HonagF/HCMUS_ADC_Oscilloscope/Photos/First_testing.jpg

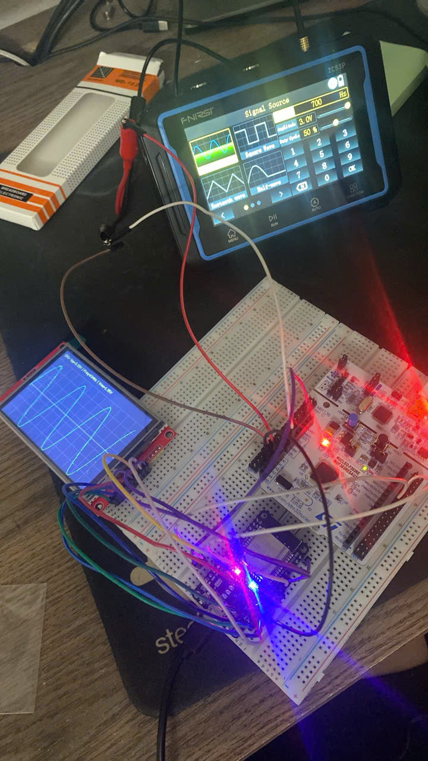
Photos/First_testing.jpg
