HonagF/HCMUS_ADC_Oscilloscope/Photos/Inside.jpg

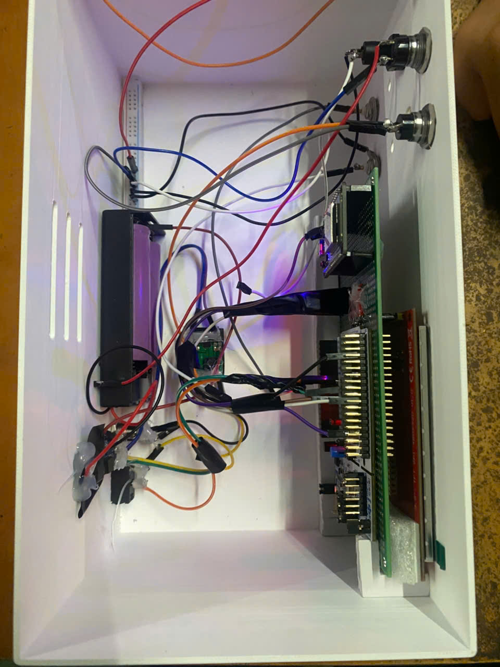
Photos/Inside.jpg
