HonagF/HCMUS_ADC_Oscilloscope/README.md

[Project Information](https://docs.google.com/document/d/1wfRh9YXK25s_UUH2y_-TGw_fSxXpMR-pIrb6TqXOmT0/edit?tab=t.250vvrg7rc1h)

https://github.com/user-attachments/assets/9503c086-c768-495d-8c4e-90152d3b3db1

 ## I. Introduction
### Project Overview
This repository hosts a self-developed **Digital Storage Oscilloscope (DSO)** project. It was built as a core team assignment for the Microcontrollers course within the Faculty of Electronics and Telecommunications at the VNU-HCM University of Science (Academic Year 2025-2026).

The architecture utilizes a distributed processing layout across a hybrid multi-microcontroller setup to ensure smooth, high-speed performance:
* **Data Acquisition Block (STM32F303RE):** Handles high-speed analog signal sampling through its internal 12-bit ADC, utilizing DMA to offload data storage from the CPU pipeline.
* **Processing & Display Block (ESP32):** Manages incoming data packets over SPI, executes processing tasks, hosts the web interface, and handles graphical UI rendering.
* **Human-Machine Interface (HMI):** Displays waveforms smoothly on a 3.5-inch TFT touch screen powered by the ILI9488 controller (320x480 pixel resolution).

The system combines concepts from Basic Electronics, Digital Electronics, Analog Electronics, and Microcontrollers to deliver a functional measurement tool tailored for educational settings and fundamental laboratory testing.

---

Our **DualCore Scope** team:

| Name | Roles & Responsibilities |
| :--- | :--- |
| [**Vũ Quốc Hùng**](https://github.com/HungVulkan) | <ul><li>Team Leader</li><li>Hardware Development</li><li>GitHub Management</li></ul> |
| [**Nguyễn Minh Hoàng**](https://github.com/HonagF) | <ul><li>Firmware (STM32, ESP32)</li><li>System Functions & UI Display</li><li>GitHub Management</li></ul> |
| **Đặng Hữu Trung Kiên** | <ul><li>3D design</li><li>Slide Preparation</li></ul> |
| **Đỗ Hoàng Đạt** | <ul><li>Firmware (ESP32), web interface</li><li>Hardware Assistance</li></ul> |

 ## II. Hardware

| Component | Model | Quantity |
|---|---|---|
| Microcontroller | STM32F303RE (Nucleo-64) | 1 |
| WiFi MCU | ESP32 DevKit V1 | 1 |
| Display | ILI9488 3.5" TFT SPI | 1 |
| Signal input | BNC Female Header | 2 |
| User input | Momentary pushbutton | 3 |
| User input | Latching pushbutton | 2 |
| User input | Rotary encoder | 1 |
| Signal conditioning | Custom signal adjustment circuit | 2 |
| Power | 7.4V power supply → 8.4V boosted | 1 |

<p align="center">
  NUCLEO-F303RE Board
</p>
<p align="center">
  ESP32_DevKit_V1
</p>
<p align="center">

</p>

Although we designed this circuit, when we built it on a perfboard, it worked initially but broke down a few days later. Due to time constraints, we had to abandon it. We hope you will carry on this work in our place.
<p align="center">

</p>

---
 ## III. Software
For the software, besides the signal processing algorithm on the STM32F303RE, we designed an interface on a 3.5-inch TFT SPI display using the ILI9488. Due to local stock limitations, a touchscreen version was provisionally used instead of the standard non-touch model. (Users could also opt for more common alternatives like the 2.8-inch ILI9341 to fit their needs)
<p align="center">

</p>

Additionally, we have developed an interface on the ESP32, along with other features, making it open-source for further development.
<p align="center">

</p>
