HonagF/HCMUS_ADC_Oscilloscope/Photos/Back_MCU.jpg

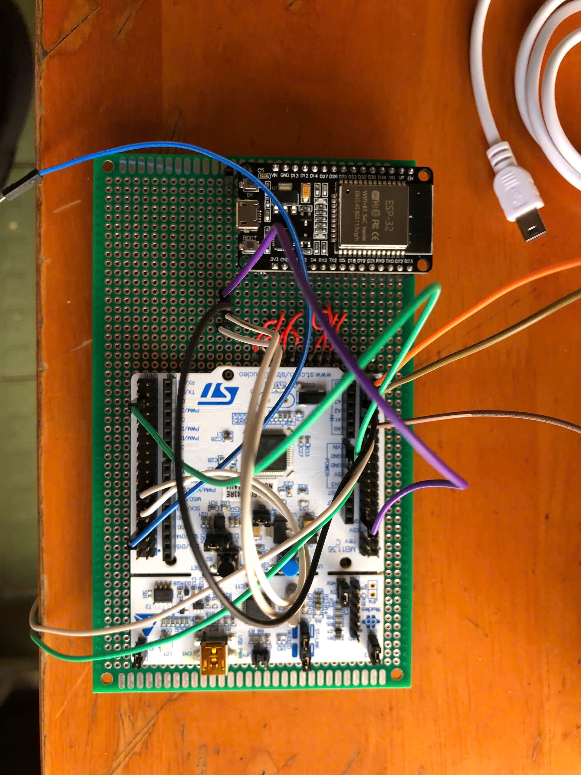
Photos/Back_MCU.jpg
