HonagF/HCMUS_ADC_Oscilloscope/Photos/Front_MCU.jpg

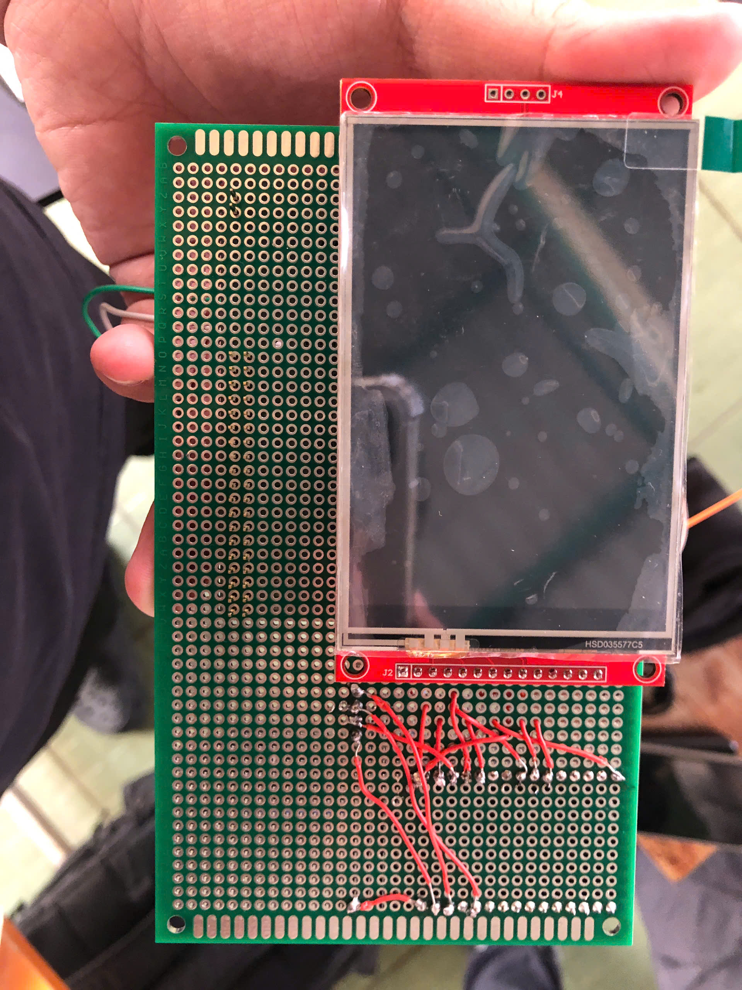
Photos/Front_MCU.jpg
