HonagF/HCMUS_ADC_Oscilloscope/Photos/Signal_adjustment_circuit.jpg

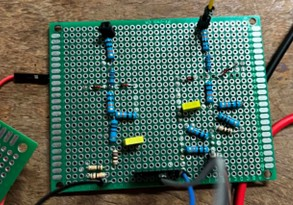
Photos/Signal_adjustment_circuit.jpg
