HonagF/HCMUS_ADC_Oscilloscope/Photos/Tesing_SAC.png

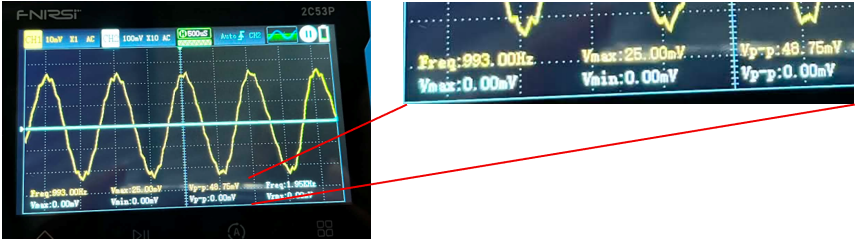
Photos/Tesing_SAC.png
