HonagF/HCMUS_ADC_Oscilloscope/Photos/UIUX_LCD.jpg

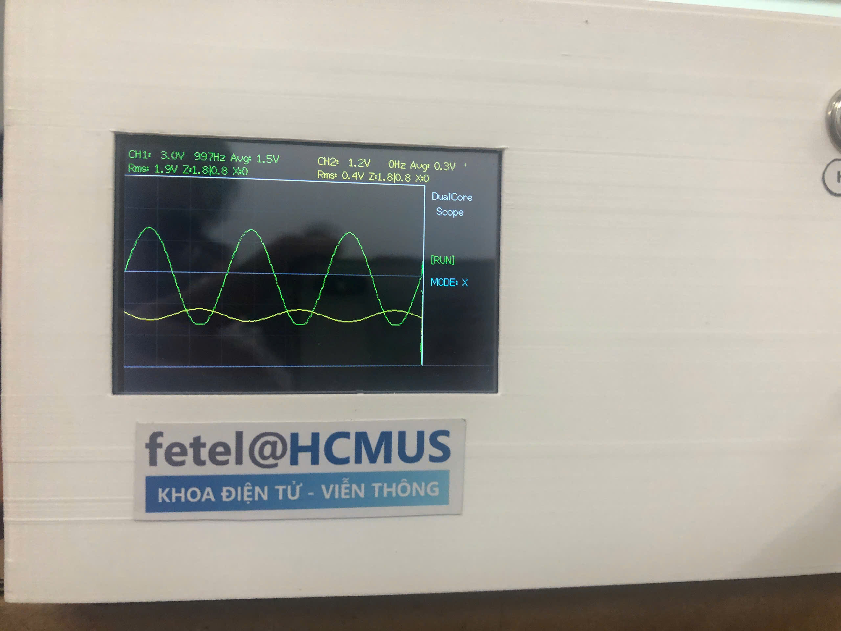
Photos/UIUX_LCD.jpg
