HonagF/HCMUS_ADC_Oscilloscope/Photos/UIUX_LCD_2.jpg

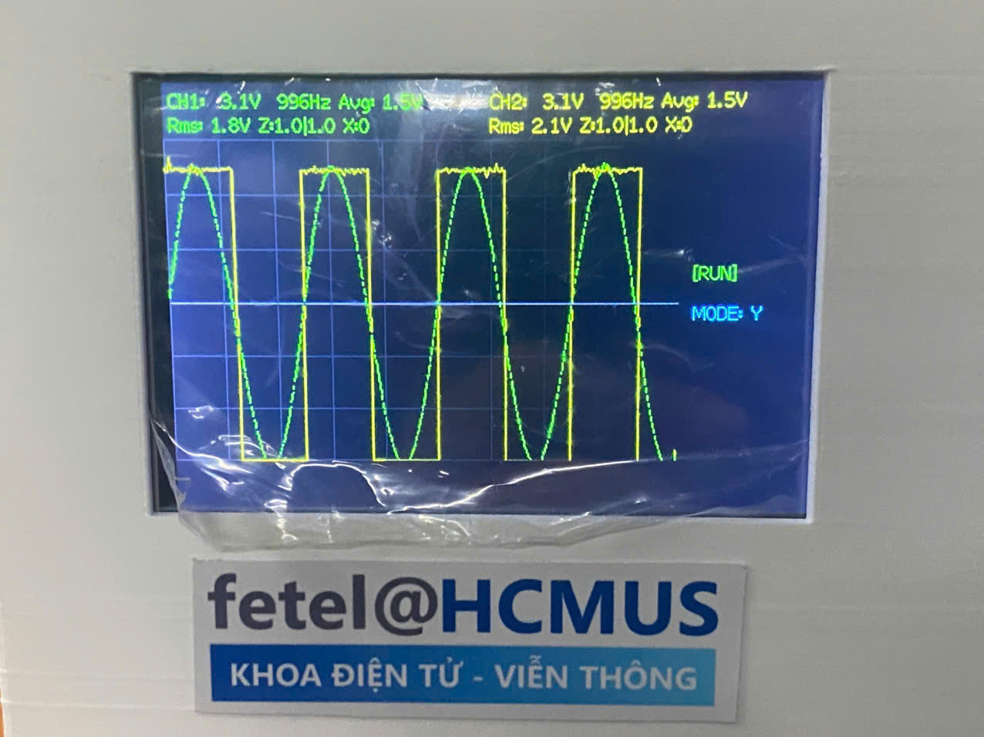
Photos/UIUX_LCD_2.jpg
