HonagF/HCMUS_ADC_Oscilloscope/Photos/We_did_it.jpg

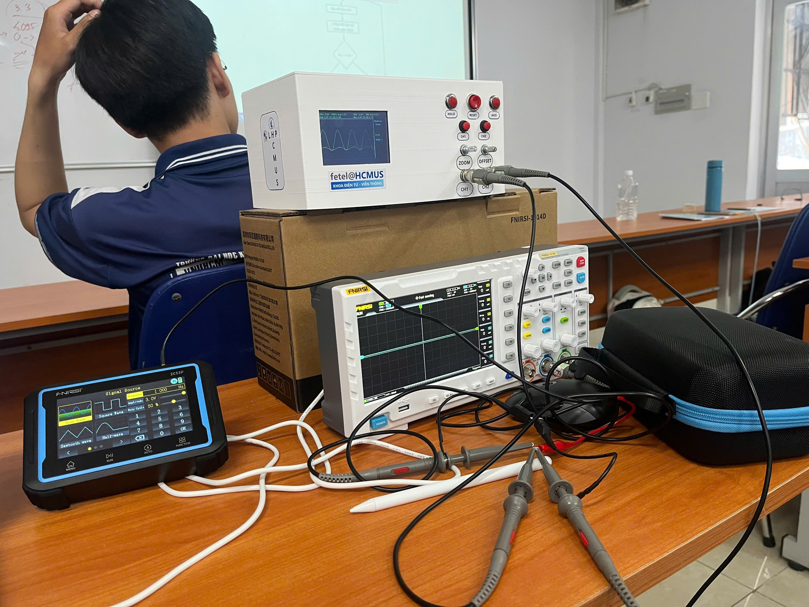
Photos/We_did_it.jpg
