HonagF/HCMUS_ADC_Oscilloscope/Photos/Web_interface.png

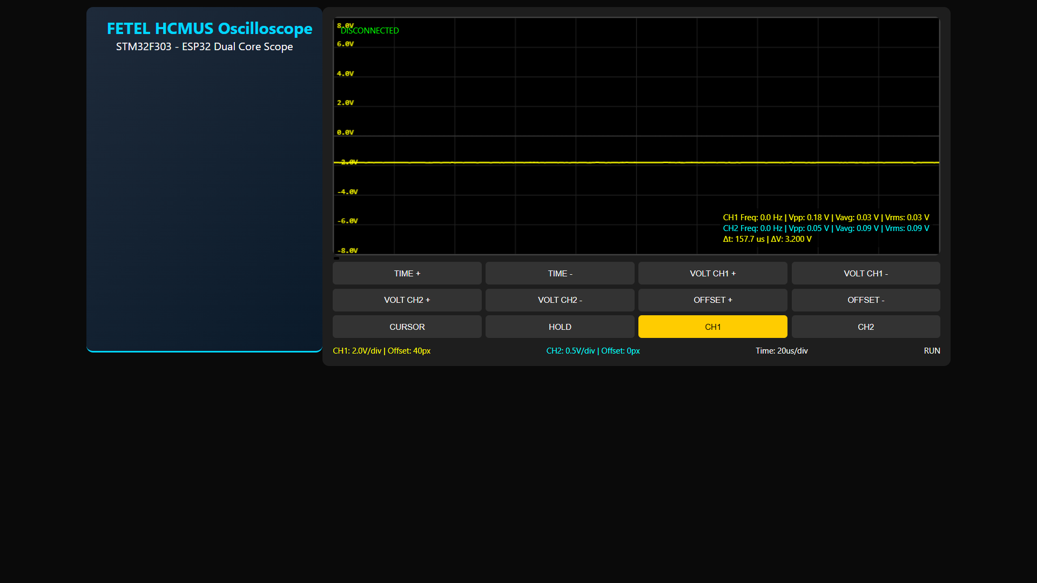
Photos/Web_interface.png
