HonagF/HCMUS_ADC_Oscilloscope/schematic/ESP32.png

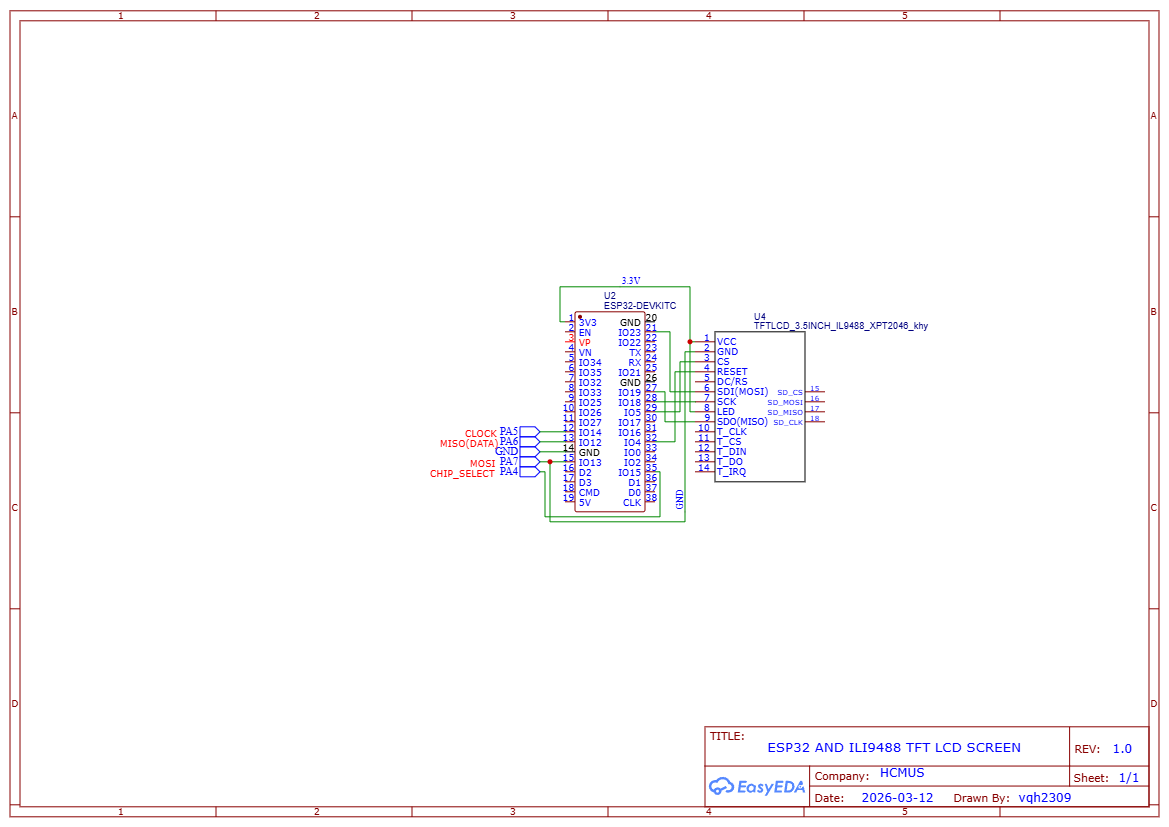
schematic/ESP32.png
