HonagF/HCMUS_ADC_Oscilloscope/schematic/FUNCTION.png

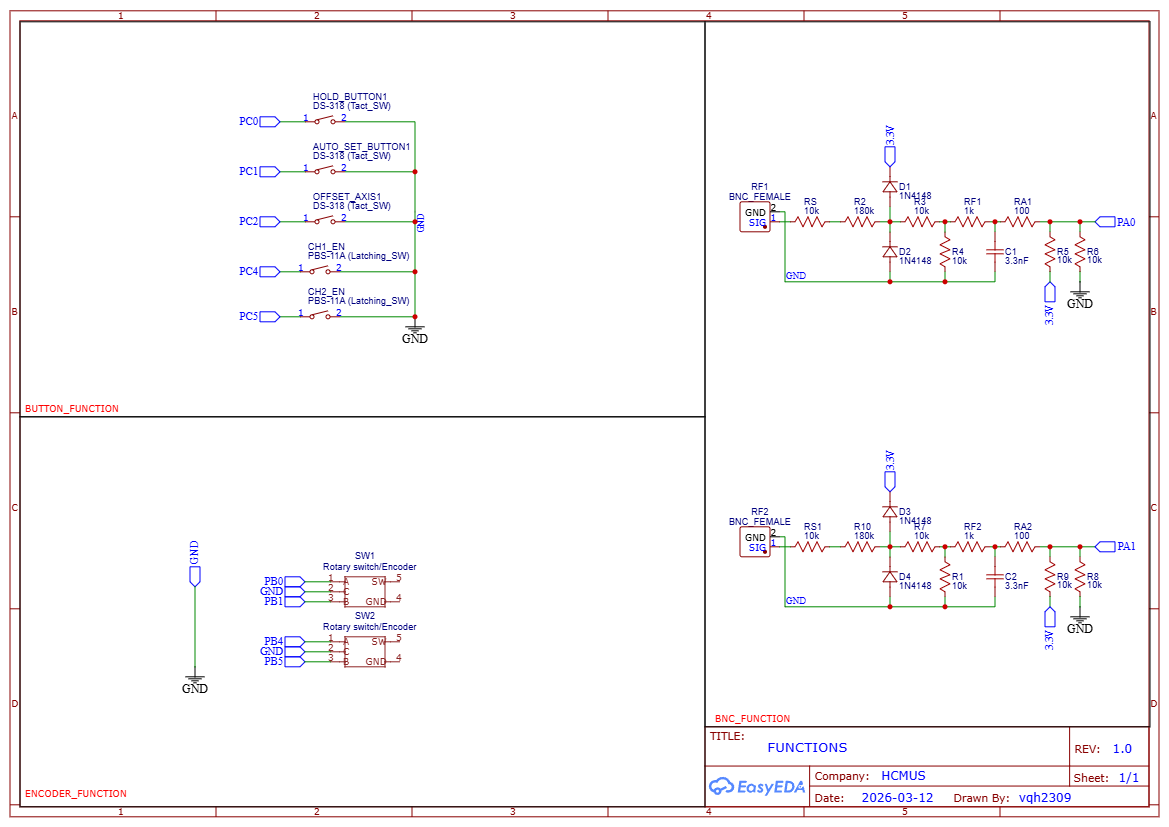
schematic/FUNCTION.png
