HonagF/HCMUS_ADC_Oscilloscope/schematic/STM32.png

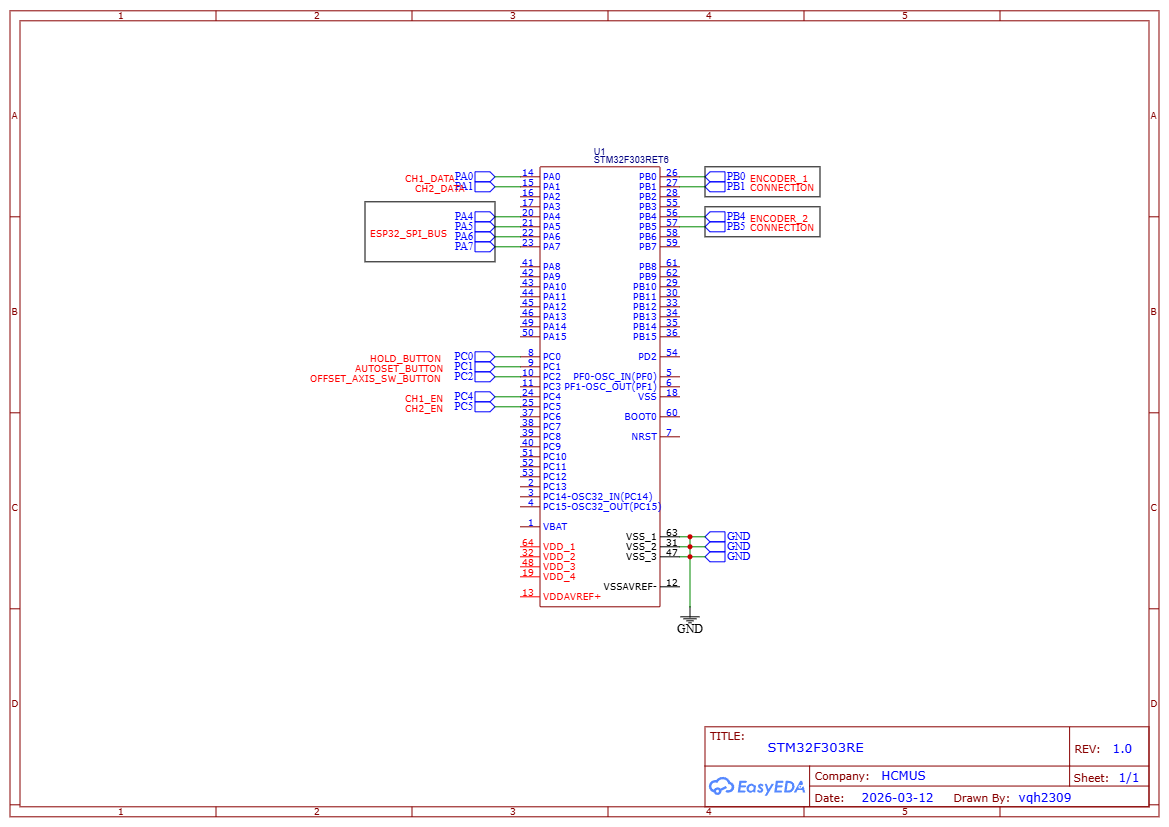
schematic/STM32.png
