HonagF/HCMUS_ADC_Oscilloscope/STM32Firmware/STM32Firmware.ioc

Mcu.UserName=STM32F303RETx
PA0.Signal=ADC1_IN1
PA13.GPIO_Label=TMS
PA13.Signal=SYS_JTMS-SWDIO
PA14.GPIO_Label=TCK
PA14.Signal=SYS_JTCK-SWCLK
PA2.GPIO_Label=USART_TX
PA2.Signal=USART2_TX
PA3.GPIO_Label=USART_RX
PA3.Signal=USART2_RX
PA4.GPIO_Label=SPI_CS
PA4.Signal=GPIO_Output
PA5.Signal=SPI1_SCK
PA6.Signal=GPIO_Output
PA7.Signal=SPI1_MOSI
PB0.Signal=GPIO_Input
PB1.Signal=GPIO_Input
PB3.GPIO_Label=SWO
PB3.Signal=SYS_JTDO-TRACESWO
PB4.Signal=GPIO_Input
PB5.Signal=GPIO_Input
PC0.Signal=GPIO_Input
PC1.Signal=GPIO_Input
PC13.GPIO_Label=B1 [Blue PushButton]
PC13.Signal=GPXTI13
PC14-OSC32_IN.Signal=RCC_OSC32_IN
PC15-OSC32_OUT.Signal=RCC_OSC32_OUT
PC2.Signal=GPIO_Input
PC3.Signal=ADCx_IN9
PC4.Signal=GPIO_Input
PC5.Signal=GPIO_Input
PF0-OSC_IN.Signal=RCC_OSC_IN
PF1-OSC_OUT.Signal=RCC_OSC_OUT
