HonagF/HCMUS_ADC_Oscilloscope/STM32Firmware/Core/Src/main.c

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
/* Includes ------------------------------------------------------------------*/
#include "main.h"

/* USER CODE BEGIN Includes */
#include <string.h>
#include <math.h>
/* USER CODE END Includes */

ADC_HandleTypeDef hadc1;
ADC_HandleTypeDef hadc2;
DMA_HandleTypeDef hdma_adc1;
DMA_HandleTypeDef hdma_adc2;

SPI_HandleTypeDef hspi1;
DMA_HandleTypeDef hdma_spi1_tx;

TIM_HandleTypeDef htim3;

UART_HandleTypeDef huart2;

/* USER CODE BEGIN PV */
// Set số lượng mẫu thu thập cho mỗi khung hình là 1024 mẫu/kênh
#define SAMPLES_PER_CH    1024
// Tổng số mẫu DMA cần lấy = Kênh 1 + Kênh 2
#define TOTAL_SAMPLES	(SAMPLES_PER_CH * 2)

// Khai báo struct đóng gói dữ liệu truyền qua SPI.
// dùng __attribute__((packed)) để vô hiệu hóa tính năng tự động đệm (padding) của GCC.
typedef struct __attribute__((packed)){
	uint8_t header[2]; // Byte header: 0xAA, 0xBB để ESP32 nhận diện điểm bắt đầu gói tin
	uint16_t ch1[SAMPLES_PER_CH]; // Dữ liệu thô ADC Kênh 1 (1024 mẫu * 2 byte = 2048 bytes)
	uint16_t ch2[SAMPLES_PER_CH]; // Dữ liệu thô ADC Kênh 2 (1024 mẫu * 2 byte = 2048 bytes)
	uint8_t padding[2]; // 2 byte padding thủ công để chống lỗi Hardfault do Misaligned memory access trên vi điều khiển ARM

	// Các thông số điện áp & thời gian đo được
	float vpp1, vpp2; // Điện áp đỉnh-đỉnh (Peak-to-Peak)
	float freq1, freq2; // Tần số (Frequency)
	float vavg1, vavg2; // Điện áp trung bình (Average/DC Offset)
	float vrms1, vrms2; // Điện áp hiệu dụng thực (True RMS)
	float vamp1, vamp2; // Biên độ sóng (Amplitude)
	uint16_t trigger_idx1; // Vị trí điểm kích hoạt (Trigger Point) trong mảng để ESP32 làm mốc vẽ sóng
	uint16_t trigger_idx2;

	// --- KHỐI ĐIỀU KHIỂN (Giao tiếp với giao diện LCD) ---
	uint8_t hold_flag; // Cờ dừng màn hình (0: Đang chạy, 1: Giữ nguyên khung hình)
	uint8_t ch_mode;   // Cờ bitmask chọn kênh hiển thị (1: CH1, 2: CH2, 3: Bật cả 2 kênh)
	float y_scale1;    // Hệ số phóng to/thu nhỏ trục Y của CH1 (điều khiển bởi Encoder 1)
	float y_scale2;    // Hệ số phóng to/thu nhỏ trục Y của CH2 (điều khiển bởi Encoder 1)
	float x_scale1;	   // Hệ số thu phóng trục X của CH1
	float x_scale2;    // Hệ số thu phóng trục Y của CH2
	int16_t y_offset1; // Số pixel dịch chuyển sóng lên/xuống của CH1
	int16_t y_offset2; // Số pixel dịch chuyển sóng lên/xuống của CH2

	// --- KHỐI OFFSET X/Y ---
	uint8_t offset_axis; // Trạng thái của nút nhấn: 0 đang chọn chỉnh Y, 1 đang chọn chỉnh X
	int16_t x_offset1; // Số pixel dịch chuyển trục thời gian (X) cho CH1
	int16_t x_offset2; // Số pixel dịch chuyển trục thời gian (X) cho CH2
	uint8_t reset_flag; // Cờ reset

	uint8_t footer[2]; // Byte footer: 0xCC, 0xDD
} Packet_t;

Packet_t tx_packet; // Khởi tạo biến toàn cục chứa gói tin
#define PACKET_SIZE sizeof(Packet_t)
uint8_t adc_running = 1;
volatile uint8_t adc1_ready = 0;
volatile uint8_t adc2_ready = 0;
volatile uint8_t is_holding = 0;
/* USER CODE END PV */

void SystemClock_Config(void);
static void MX_GPIO_Init(void);
static void MX_DMA_Init(void);
static void MX_TIM3_Init(void);
static void MX_USART2_UART_Init(void);
static void MX_SPI1_Init(void);
static void MX_ADC1_Init(void);
static void MX_ADC2_Init(void);
/* USER CODE BEGIN PFP */
// Hàm xử lý tín hiệu: Tìm Trigger, tính Vrms, Vpp, Freq
uint16_t Process_Signal(uint16_t* raw_data, float* vpp, float* freq, float* vavg, float* vrms, float* vamp);
/* USER CODE END PFP */

/**
  * @brief  The application entry point.
  * @retval int
  */
int main(void)
{

  /* MCU Configuration--------------------------------------------------------*/

  /* Reset of all peripherals, Initializes the Flash interface and the Systick. */
  HAL_Init();

  /* Configure the system clock */
  SystemClock_Config();

  /* Initialize all configured peripherals */
  MX_GPIO_Init();
  MX_DMA_Init();
  MX_TIM3_Init();
  MX_USART2_UART_Init();
  MX_SPI1_Init();
  MX_ADC1_Init();
  MX_ADC2_Init();
  /* USER CODE BEGIN 2 */
  // Khởi tạo ban đầu: Chốt chân Chip Select (CS) của SPI ở mức CAO (Không truyền)
  HAL_GPIO_WritePin(GPIOA, GPIO_PIN_4, GPIO_PIN_SET);

  // Set cứng các byte Header và Footer để định dạng gói tin giao thức
  tx_packet.header[0] = 0xAA;
  tx_packet.header[1] = 0xBB;
  tx_packet.footer[0] = 0xCC;
  tx_packet.footer[1] = 0xDD;



  // Calib ADC để loại bỏ sai số nội vi trước khi chạy thực tế
//  HAL_ADCEx_Calibration_Start(&hadc1, ADC_SINGLE_ENDED);
//  HAL_ADCEx_Calibration_Start(&hadc2, ADC_SINGLE_ENDED);
  // Kích hoạt bộ chuyển đổi ADC chạy ở chế độ DMA Circular
  HAL_ADC_Start_DMA(&hadc1, (uint32_t*)tx_packet.ch1, SAMPLES_PER_CH);
  HAL_ADC_Start_DMA(&hadc2, (uint32_t*)tx_packet.ch2, SAMPLES_PER_CH);

  // Khởi động Timer 3. Timer 3 được cấu hình làm TRGO (Trigger Output) tạo xung đập nhịp 100kHz để kích ADC lấy mẫu.
  HAL_TIM_Base_Start(&htim3);

  // Khởi tạo các biến quản lý trạng thái
  uint32_t last_btn_tick = 0;
  tx_packet.y_scale1 = 1.0f;
  tx_packet.y_scale2 = 1.0f;
  tx_packet.x_scale1 = 1.0f;
  tx_packet.x_scale2 = 1.0f;
  tx_packet.y_offset1 = 0;
  tx_packet.y_offset2 = 0;
  tx_packet.offset_axis = 0;
  tx_packet.x_offset1 = 0;
  tx_packet.x_offset2 = 0;

  // Biến lưu trạng thái của 2 chân CLK Encoder để so sánh cạnh xuống
  uint8_t last_clk1 = 1;
  uint8_t last_clk2 = 1;
  // Khởi tạo 2 biến dùng để chống dội phím (Debounce) cho Encoder
  uint32_t last_enc1_tick = 0;
  uint32_t last_enc2_tick = 0;
  /* USER CODE END 2 */

  /* Infinite loop */
  /* USER CODE BEGIN WHILE */


  while (1)
  {
    /* USER CODE END WHILE */

    /* USER CODE BEGIN 3 */
	  uint32_t current_tick = HAL_GetTick(); // Lấy thời gian ms hiện tại của hệ thống

	  //--- 1. ĐỌC CÔNG TẮC CHỌN KÊNH ---
	  // Kiểm tra chân PC4 và PC5
	  uint8_t ch1_en = (HAL_GPIO_ReadPin(GPIOC, GPIO_PIN_4) == GPIO_PIN_RESET) ? 1:0;
	  uint8_t ch2_en = (HAL_GPIO_ReadPin(GPIOC, GPIO_PIN_5) == GPIO_PIN_RESET) ? 2:0;
	  // Dùng phép toán OR Bitmask để gộp chung cờ hiển thị (1: bật CH1, 2: bật CH2, 3: bật cả 2)
	  tx_packet.ch_mode = ch1_en | ch2_en;

	  //--- 2. ĐỌC NÚT NHẤN (Có Debounce 200ms) ---
	  // Giải thuật chống rung: Chỉ chấp nhận lần bấm tiếp theo nếu khoảng cách giữa 2 lần bấm cách nhau > 200ms.
	  if(current_tick - last_btn_tick > 200){

		  // Nút Dừng hình / Chạy tiếp (Hold)
		  if (HAL_GPIO_ReadPin(GPIOC, GPIO_PIN_0) == GPIO_PIN_RESET){
		                is_holding = !is_holding;
		                tx_packet.hold_flag = is_holding;

		                // ĐIỀU KHIỂN ADC THEO TRẠNG THÁI HOLD
		                if (is_holding) {
		                    HAL_ADC_Stop_DMA(&hadc1);
		                    HAL_ADC_Stop_DMA(&hadc2);
		                    adc_running = 0;
		                } else {
		                    HAL_ADC_Start_DMA(&hadc1, (uint32_t*)tx_packet.ch1, SAMPLES_PER_CH);
		                    HAL_ADC_Start_DMA(&hadc2, (uint32_t*)tx_packet.ch2, SAMPLES_PER_CH);
		                    adc_running = 1;
		                }

		                last_btn_tick = current_tick;
		  }
		  // Nút Autoset (Trả mọi thông số về default)
		  else if (HAL_GPIO_ReadPin(GPIOC, GPIO_PIN_1) == GPIO_PIN_RESET){
			  tx_packet.x_scale1 = 1.0f;
			  tx_packet.x_scale2 = 1.0f;
			  tx_packet.y_scale1 = 1.0f; // Trả hệ số zoom trục Y về 1x
			  tx_packet.y_scale2 = 1.0f;
			  tx_packet.y_offset1 = 0;   // Trả vị trí gốc Y về giữa màn hình
			  tx_packet.y_offset2 = 0;
			  tx_packet.x_offset1 = 0;   // Trả gốc thời gian X về ban đầu
			  tx_packet.x_offset2 = 0;
			  tx_packet.offset_axis = 0;
			  tx_packet.reset_flag = 1;  // Bật cờ để ra lệnh cho ESP32 clear màn hình
			  last_btn_tick = current_tick;
		  }
		  // Nút Chuyển chế độ điều khiển trục (X hoặc Y)
		  else if (HAL_GPIO_ReadPin(GPIOC, GPIO_PIN_2) == GPIO_PIN_RESET){
			  tx_packet.offset_axis = !tx_packet.offset_axis; // Đảo trạng thái 0 <-> 1
			  last_btn_tick = current_tick;
		  }
	  }

	  //--- 3. ĐỌC ROTARY ENCODER ---
	  	  // ENCODER 1: Dùng để phóng to/thu nhỏ sóng (Scale Y/X)
	  	  uint8_t clk1 = HAL_GPIO_ReadPin(GPIOB, GPIO_PIN_0);

	  	  // Phát hiện cạnh xuống và đảm bảo khoảng cách giữa 2 lần nhận tín hiệu tối thiểu là 50ms (chống dội)
	  	  if (clk1 == 0 && last_clk1 == 1 && (current_tick - last_enc1_tick > 20)){

	  		  // Nếu chân DT khác mức logic của CLK -> Quay cùng chiều kim đồng hồ (Tăng). Ngược lại là giảm.
	  		  float delta = (HAL_GPIO_ReadPin(GPIOB, GPIO_PIN_1) != clk1) ? 0.2f : -0.2f;
	  		  if (tx_packet.offset_axis == 0){
	  			 if (ch1_en) {
	  				 tx_packet.y_scale1 += delta;
	  				 if (tx_packet.y_scale1 < 0.2f) tx_packet.y_scale1 = 0.2f;
	  				 if (tx_packet.y_scale1 > 5.0f) tx_packet.y_scale1 = 5.0f;
	  			 }
	  			 if (ch2_en) {
	  				tx_packet.y_scale2 += delta;
	  				if (tx_packet.y_scale2 < 0.2f) tx_packet.y_scale2 = 0.2f;
	  				if (tx_packet.y_scale2 > 5.0f) tx_packet.y_scale2 = 5.0f;
	  			 }
	  		  } else {
	  			if (ch1_en) {
	  				tx_packet.x_scale1 += delta;
	  				if (tx_packet.x_scale1 < 0.8f) tx_packet.x_scale1 = 0.8f;
	  				if (tx_packet.x_scale1 > 2.5f) tx_packet.x_scale1 = 2.5f;
	  			}
	  			if (ch2_en) {
	  				tx_packet.x_scale2 += delta;
	  				if (tx_packet.x_scale2 < 0.8f) tx_packet.x_scale2 = 0.8f;
	  				if (tx_packet.x_scale2 > 2.5f) tx_packet.x_scale2 = 2.5f;
	  			}
	  		  }
	  		  last_enc1_tick = current_tick; // Chốt thời gian lặp để block các tín hiệu nhiễu tiếp theo
	  	  }
	  	  last_clk1 = clk1;

	  	  // ENCODER 2: Dùng để dịch chuyển vị trí sóng theo trục ngang (X) hoặc dọc (Y)
	  	  uint8_t clk2 = HAL_GPIO_ReadPin(GPIOB, GPIO_PIN_4);

	  	  if (clk2 == 0 && last_clk2 == 1 && (current_tick - last_enc2_tick > 10)){

	  	  		int delta_y = (HAL_GPIO_ReadPin(GPIOB, GPIO_PIN_5) != clk2) ? -10 : 10;
	  	  		int delta_x = (HAL_GPIO_ReadPin(GPIOB, GPIO_PIN_5) != clk2) ? -5 : 5;

	  	        if (tx_packet.offset_axis == 0) {
	  	            // --- CHẾ ĐỘ 0: ĐANG CHỌN DỊCH THEO TRỤC Y ---
	  	            if(ch1_en) {
	  	                tx_packet.y_offset1 += delta_y;
	  	                if (tx_packet.y_offset1 > 200) tx_packet.y_offset1 = 200;
	  	                if (tx_packet.y_offset1 < -200) tx_packet.y_offset1 = -200;
	  	            }
	  	            if (ch2_en) {
	  	                tx_packet.y_offset2 += delta_y;
	  	                if (tx_packet.y_offset2 > 200) tx_packet.y_offset2 = 200;
	  	                if (tx_packet.y_offset2 < -200) tx_packet.y_offset2 = -200;
	  	            }
	  	        } else {
	  	            // --- CHẾ ĐỘ 1: ĐANG CHỌN DỊCH THEO TRỤC X (THỜI GIAN) ---
	  	            if(ch1_en) {
	  	                tx_packet.x_offset1 += delta_x;
	  	                if (tx_packet.x_offset1 > 250) tx_packet.x_offset1 = 250;
	  	                if (tx_packet.x_offset1 < -75) tx_packet.x_offset1 = -75;
	  	            }
	  	            if (ch2_en) {
	  	                tx_packet.x_offset2 += delta_x;
	  	                if (tx_packet.x_offset2 > 250) tx_packet.x_offset2 = 250;
	  	                if (tx_packet.x_offset2 < -75) tx_packet.x_offset2 = -75;
	  	            }
	  	        }
	  	        last_enc2_tick = current_tick;
	  	  }
	  	  last_clk2 = clk2;
	  // --- 4. TÁCH DỮ LIỆU DMA, XỬ LÝ DSP VÀ TRUYỀN SPI ---
	  // Cờ data_ready_flag được kích bởi các hàm callback ngắt của DMA khi nó điền xong Ping hoặc Pong
      if (adc1_ready == 1 && adc2_ready == 1 || is_holding) {

    	  // CẬP NHẬT VÀ XỬ LÝ SÓNG (Chỉ chạy khi người dùng KHÔNG bấm Hold)
    	  if (is_holding == 0) {
    	      tx_packet.trigger_idx1 = Process_Signal(tx_packet.ch1, &tx_packet.vpp1, &tx_packet.freq1, &tx_packet.vavg1, &tx_packet.vrms1, &tx_packet.vamp1);
        	  tx_packet.trigger_idx2 = Process_Signal(tx_packet.ch2, &tx_packet.vpp2, &tx_packet.freq2, &tx_packet.vavg2, &tx_packet.vrms2, &tx_packet.vamp2);
        	  adc1_ready = 0;
        	  adc2_ready = 0;
    	  }

    	  // Luôn truyền SPI để Web/LCD cập nhật được trạng thái [STOP]/[RUN]
    	  // và các lệnh Encoder Zoom/Offset vẫn có tác dụng trên hình tĩnh.
    	  if (HAL_SPI_GetState(&hspi1) == HAL_SPI_STATE_READY) {
    		  HAL_GPIO_WritePin(GPIOA, GPIO_PIN_4, GPIO_PIN_RESET);
    		  HAL_SPI_Transmit_DMA(&hspi1, (uint8_t*)&tx_packet, PACKET_SIZE);
    	  }

    	  // Nếu đang HOLD, ta thêm một chút delay nhỏ để vòng lặp không chạy quá nhanh gây nghẽn SPI
    	  if (is_holding) {
    		  HAL_Delay(50);
    	  }
      }
  }
  /* USER CODE END 3 */
}

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
/* USER CODE BEGIN 4 */
// Callback được gọi tự động khi DMA điền đầy NỬA SAU mảng adc_buffer (Pong)
void HAL_ADC_ConvCpltCallback(ADC_HandleTypeDef* hadc) {
    if(hadc->Instance == ADC1) {
    	adc1_ready = 1; // Luồng DMA của ADC1 xong -> Bật flag kênh 1
    }
    if(hadc->Instance == ADC2) {
    	adc2_ready = 1; // Luồng DMA của ADC2 xong -> Bật flag kênh 2
    }
}

// Callback được gọi tự động sau khi DMA hoàn thành việc bắn toàn bộ gói SPI sang ESP32
void HAL_SPI_TxCpltCallback(SPI_HandleTypeDef *hspi) {
    if(hspi->Instance == SPI1) {
        HAL_GPIO_WritePin(GPIOA, GPIO_PIN_4, GPIO_PIN_SET);// Kéo chân CS lên mức CAO để chốt quá trình truyền và giải phóng bus
        if (is_holding == 0){
        	HAL_ADC_Start_DMA(&hadc1, (uint32_t*)tx_packet.ch1, SAMPLES_PER_CH);
        	HAL_ADC_Start_DMA(&hadc2, (uint32_t*)tx_packet.ch2, SAMPLES_PER_CH);
        }
    }
}

// Hàm DSP xử lý tín hiệu: Tìm Max, Min, RMS, Vavg, Tần số và tính toán điểm Trigger
uint16_t Process_Signal(uint16_t* raw_data, float* vpp, float* freq, float* vavg, float* vrms, float* vamp) {
    uint16_t max = 0, min = 4095;
    uint32_t sum = 0;
    uint64_t sum_sq = 0;

    // 1. Quét mảng tìm Max, Min và Cộng dồn
    for(int i = 0; i < SAMPLES_PER_CH; i++) {
        uint16_t val = raw_data[i];
        if(val > max) max = val;
        if(val < min) min = val;
        sum += val;
        sum_sq += (uint64_t)val * val;
    }

    float adc_to_volt = 3.3f / 4095.0f;

    // 2. Tính toán Điện áp (Bỏ phép nhân 2 vì ông cắm thẳng máy FNIRSI 0-3V)
    *vpp = (float)(max - min) * adc_to_volt;
    *vamp = *vpp / 2.0f;

    float avg_raw = (float)sum / SAMPLES_PER_CH;
    *vavg = avg_raw * adc_to_volt;
    *vrms = sqrtf((float)sum_sq / SAMPLES_PER_CH) * adc_to_volt;

    // ---------------------------------------------------------
    // 3. THUẬT TOÁN ĐO TẦN SỐ (ĐÃ NÂNG CẤP CHỐNG NHIỄU GAI)
    // Dùng trung bình cộng làm Trigger Level thay vì Max/Min
    int16_t trigger_level = (int16_t)avg_raw;

    // Siết chặt độ trễ (Hysteresis) ở khoảng 10-40 đơn vị để nhạy bén hơn
    int16_t hysteresis = (max - min) * 2 / 100;
    if (hysteresis < 10) hysteresis = 10;
    if (hysteresis > 40) hysteresis = 40;

    int first_cross_freq = -1;
    int last_cross_freq = -1;
    int period_count = 0;

    uint8_t is_low = (raw_data[0] < trigger_level) ? 1 : 0;
    for(int i = 0; i < SAMPLES_PER_CH; i++) {
        if(is_low == 1 && raw_data[i] > (trigger_level + hysteresis)) {
            if (first_cross_freq == -1) {
                first_cross_freq = i; // Ghi nhận lần cắt đầu tiên
            } else {
                last_cross_freq = i;  // Cập nhật lần cắt cuối cùng
                period_count++;
            }
            is_low = 0;
        }
        else if(is_low == 0 && raw_data[i] < (trigger_level - hysteresis)) {
            is_low = 1;
        }
    }

    // Tính tần số an toàn, chống lỗi chia cho 0
    if(period_count > 0 && last_cross_freq > first_cross_freq) {
        *freq = (100000.0f * period_count) / (float)(last_cross_freq - first_cross_freq);
    } else {
        *freq = 0;
    }

    // ---------------------------------------------------------
    // 4. TÌM ĐIỂM NEO VẼ SÓNG (TRIGGER CHO ESP32)
    uint16_t display_trigger = 50;
    uint8_t trig_is_low = (raw_data[50] < trigger_level) ? 1 : 0;

    // Chỉ quét đến (1024 - 400) để đảm bảo ESP32 luôn có đủ 400 điểm ảnh để vẽ, không bị rác màn hình
    int max_trigger_index = SAMPLES_PER_CH - 400;

    for(int i = 50; i < max_trigger_index; i++) {
        if(trig_is_low == 1 && raw_data[i] > (trigger_level + hysteresis)) {
            display_trigger = i; // Chốt điểm Trigger!
            break;
        }
        else if(trig_is_low == 0 && raw_data[i] < (trigger_level - hysteresis)) {
            trig_is_low = 1;
        }
    }

    return display_trigger;
}
/* USER CODE END 4 */
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
