HonagF/HCMUS_ADC_Oscilloscope/ESP32Firmware/User_Setup.h

#define ILI9488_DRIVER     // Driver cho màn 3.5 inch
#define TFT_BL   32        // Nếu muốn điều khiển độ sáng bằng GPIO 32 (tùy chọn)
#define TFT_MISO 19
#define TFT_MOSI 23
#define TFT_SCLK 18
#define TFT_CS    5
#define TFT_DC    2
#define TFT_RST   4
#define LOAD_GLCD  
#define LOAD_FONT2 
#define LOAD_FONT4 
#define LOAD_FONT7 
#define SPI_FREQUENCY  40000000 // Chạy ở 40MHz cho mượt
