HonagF/HCMUS_ADC_Oscilloscope/(commit log)

2026-03-11 Done writing the firmware for STM32
    Note: Ping pong buffer algorithm terminating lost packet during SPI wait time
2026-03-13 Second version of the STM32 Firmware
    Changed most of the interface. Kept the algorithm of splitting packet in half. But the packet is now properly indicated. Updated dual channel, trigger function for stable output signal and other measurements. Yet to add gpio communication with button, switch,...
2026-03-20 V2 of the lcd test
    Added ui (simple), function from stm32
2026-03-20 Third version of the STM32 Firmware
    Added GPIO communication with button, encoder for more function. Improved edge (trigger) detection and increase packet size.
2026-03-20 The CubeMX project of the STM32 Firmware
2026-03-26 Create schematics
2026-03-27 Final (hope so) version of the STM32 Firmware
2026-04-01 Lattest ESP32 firmware
2026-04-04 we still fine hehe
    Updated power supply information and added images with descriptions. Included additional notes about circuit development and ESP32 interface.
2026-04-04 we still fine kkk
    Added images of the NUCLEO-F303RE Board, ESP32 DevKit V1, and signal adjustment circuit. Updated project notes regarding circuit issues and open-source development.
2026-07-11 latest change, fix some logic faults
    [ESP32Firmware.ino, User_Setup.h, main.c]
